ridwanultanvir/ATmega32-Drone-Hardware/README.md

# CSE316-project

CSE 316 Project - January 2021

Project Name: ATmega32-based hardware for drone

[Drone-Based-Hardware-Report.pdf](report/Drone-Based-Hardware-Report.pdf)

Brief Description:

We have created an ATmega32-based hardware for drone.

Group Members: <br />

Ridwanul Hasan Tanvir (1705016)

Shayekh Bin Islam (1705009)

 <br /> <br />

Supervisor: Dr. A. B. M. Alim Al Islam, Professor, Department of CSE, BUET
